jjc795/lilred_management/lilred_management_hardware/LilRedManagementBoard_Rev1.0/BOM/Digikey_BOM/Bill of Materials-lilred_management_board.xls

Designator | Supplier Part Number 1 | Supplier Order Qty 1 | Description | Price (1)
P2, P11 | WM7485-ND | 2 | 4 Pin Microfit Connector | 2.2
J2 | WM5899-ND | 1 | 3 Pin Screw Terminal Block | 6.35
P3 | WM4087-ND | 1 | 8 Pin Microfit connector | 3.07
P6, P9 | WM1876-ND | 2 | 3 Pin Microfit Connector | 1.39
P4, P5, P7, P8, P10, P12 | WM1870-ND | 6 | 2 Pin Microfit Connector | 0.99
P1 | S9009E-03-ND | 1 | Header, 3-Pin, Dual row | 1.13
Q3 | RSC002P03T316CT-ND | 1 | P-Channel MOSFET | 0.27
Q2, Q4, Q5, Q6, Q7, Q8, Q9 | NTR4003NT1GOSCT-ND | 7 | N-Channel MOSFET | 0.27
U1 | ATMEGA328P-AU-ND | 1 | 8-bit AVR Microcontroller, 32KB Flash, 1KB EEPROM, 2KB SRAM, 32-pin TQFP, Industrial Grade (-40°C to 85°C) | 3.58
U6 | 296-38856-1-ND | 1 | 12-Bit 50 kSPS ADC I2C Low Power 8-Channel Multiplexer Internal 2.5 V Reference, -40 to 85 degC, 16-pin SOP (PW16), Green (RoHS & no Sb/Br) | 7.39
J1 | 609-4618-1-ND | 1 | USB-Micro Type B | 0.46
Q1 | 490-1198-1-ND | 1 | Resonator | 0.48
U3, U4, U5 | 296-29034-1-ND | 3 | High or Low Side, Bidirectional Current/Power Monitor with I2C Interface | 3.44
D1 | 160-1448-1-ND | 1 | Yellow LED | 0.31
D2 | 160-1647-1-ND | 1 | Blue LED | 0.52
D3 | 160-1888-1-ND | 1 | Green LED | 0.6
D4 | 160-1447-1-ND | 1 | Red LED | 0.29
U2 | 768-1156-5-ND | 1 | FTDI Serial to USB | 2.12
L1 | 240-2389-1-ND | 1 | Ferrite Bead, 0805 | 0.1
S1 | CKN9104CT-ND | 1 | SPST Button | 0.41
C1, C21, C23 | 478-8115-1-ND | 3 | 10uF, 6.3V, 0805 tantalum pol. | 0.37
C4 | 478-8120-1-ND | 1 | 4.7uF, 6.3V, 0805 tantalum pol. | 0.32
C2, C3, C5, C7, C10, C11, C12, C16, C17, C28, C30 C32 | 490-13406-1-ND | 12 | 0.1uF, 50V, 0603 ceramic | 0.11
C6, C22, C24 | 490-1512-1-ND | 3 | 10nF, 50V, 0603 ceramic | 0.1
C8, C9 | 1276-1037-1-ND | 2 | 47pF, 50V, 0603 ceramic | 0.1
C13, C14, C15, C18, C27, C29 C31 | 490-10732-1-ND | 7 | 1uF, 50V, 0603 ceramic | 0.17
C19, C20, C25, C26 | 490-1368-1-ND | 4 | 510pF, 5V, 0603 ceramic (filter) | 0.18
R1, R5, R12, R13, R43, R44 | 311-470GRCT-ND | 6 | 470, 0603 | 0.1
R2, R9, R10 | 311-10KGRCT-ND | 3 | 10k, 0603 | 0.1
R3, R4, R14, R15, R26 | 311-2.0KGRCT-ND | 5 | 2k, 0603 | 0.1
R6, R7 | 311-1.0KGRCT-ND | 2 | 1k, 0603 | 0.1
R8, R11 | 311-27GRCT-ND | 2 | 27, 0603 | 0.1
R16, R17, R20, R21, R27, R29 | 311-1.00HRCT-ND | 6 | 1, 0603, filter | 0.1
R32, R34, R35, R36, R39, R40 | 311-100KGRCT-ND | 6 | 100k, 0603 | 0.1
R22, R23, R24, R25, R30, R31, R33, R37, R38, R41, R42, R49, R50 | 311-200GRCT-ND | 13 | 200, 0603 | 0.1
R45, R46, R51, R52 | 311-30KDCT-ND | 4 | 30k, 0603, therm pullup | 0.22
R47, R48, R53, R54 | 311-3.0MGRCT-ND | 4 | 3M, 0603, filter | 0.1
R18 | RHM1683-CT-ND | 1 | 1m, 5931, 24V sense | 1.96
R19, R28 | RHM.001APCT-ND | 2 | 1m, 1210, sense | 0.64
