jjc795/lilred_management/lilred_management_hardware/LilRedManagementBoard_Rev1.0/lilred_management_board.PDF

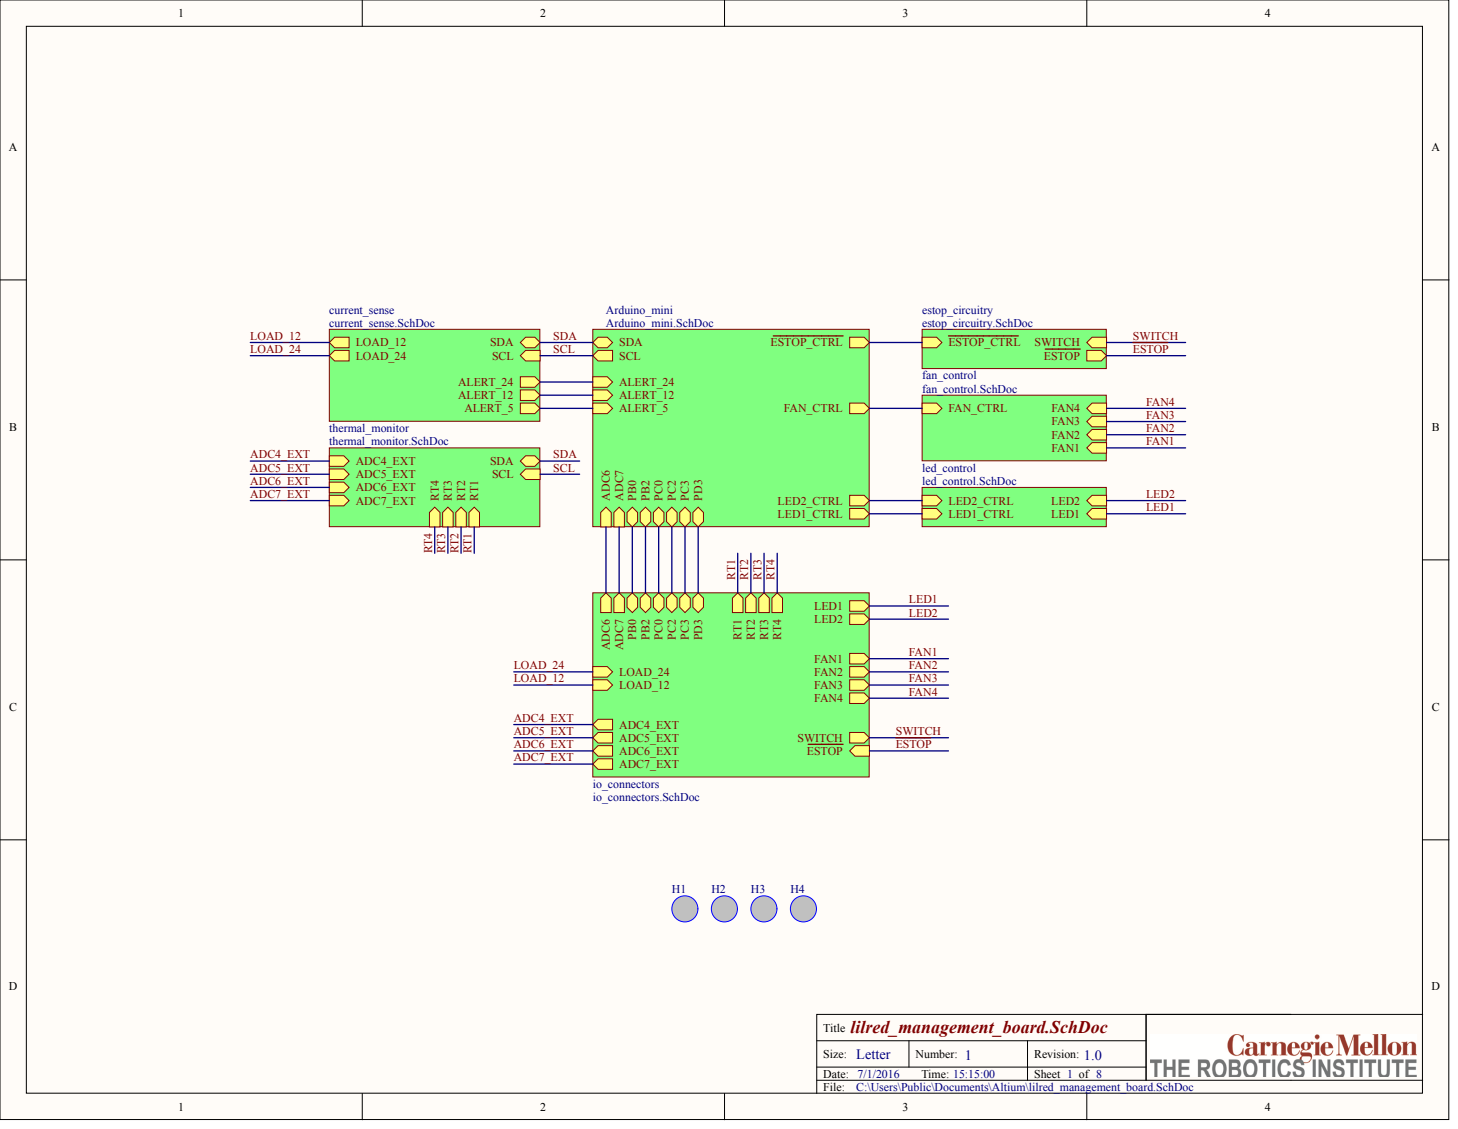
[picture p1: page 1]

Title lilred_management_board.SchDoc

Size: Letter | Number: 1 | Revision: 1.0
Date: 7/1/2016 Time: 15:15:00 | | Sheet 1 of 8
File: C:\Users\Public\Documents\Altium\lilred_management_board.SchDoc

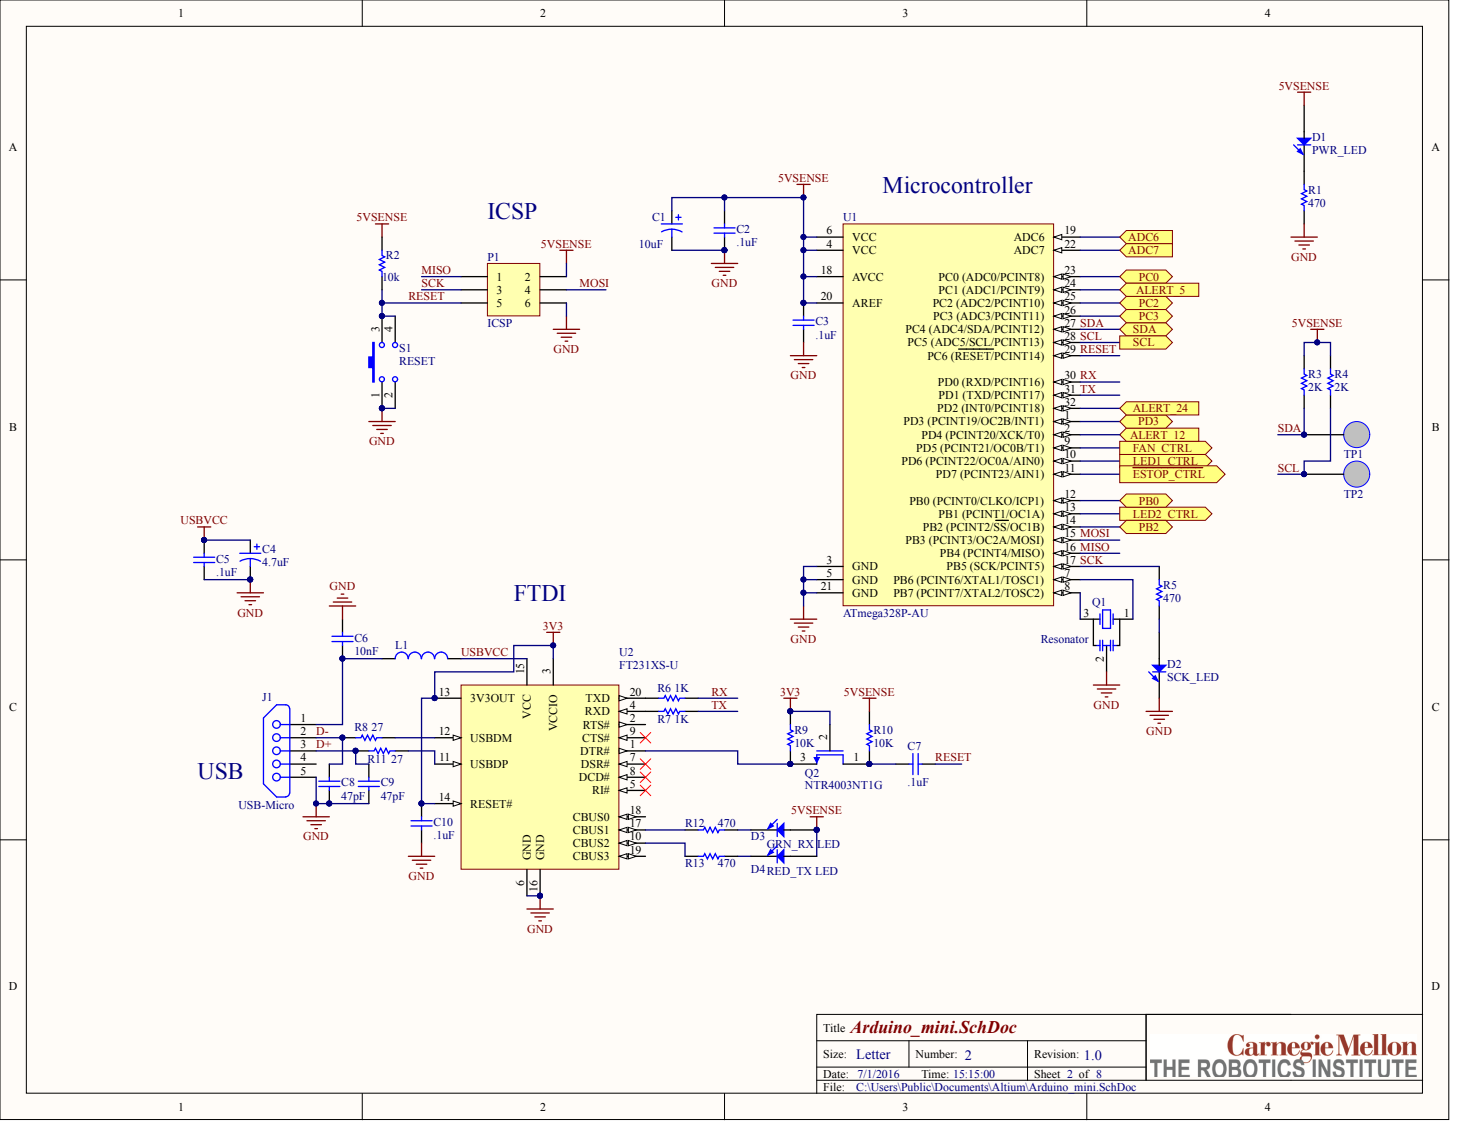
[picture p2: page 2]

5VSENSE | D1

Title Arduino_mini.SchDoc

Size: Letter | Number: 2 | Revision: 1.0
Date: 7/1/2016 Time: 15:15:00 | | Sheet 2 of 8
File: C:\Users\Public\Documents\Altium\Arduino_mini.SchDoc

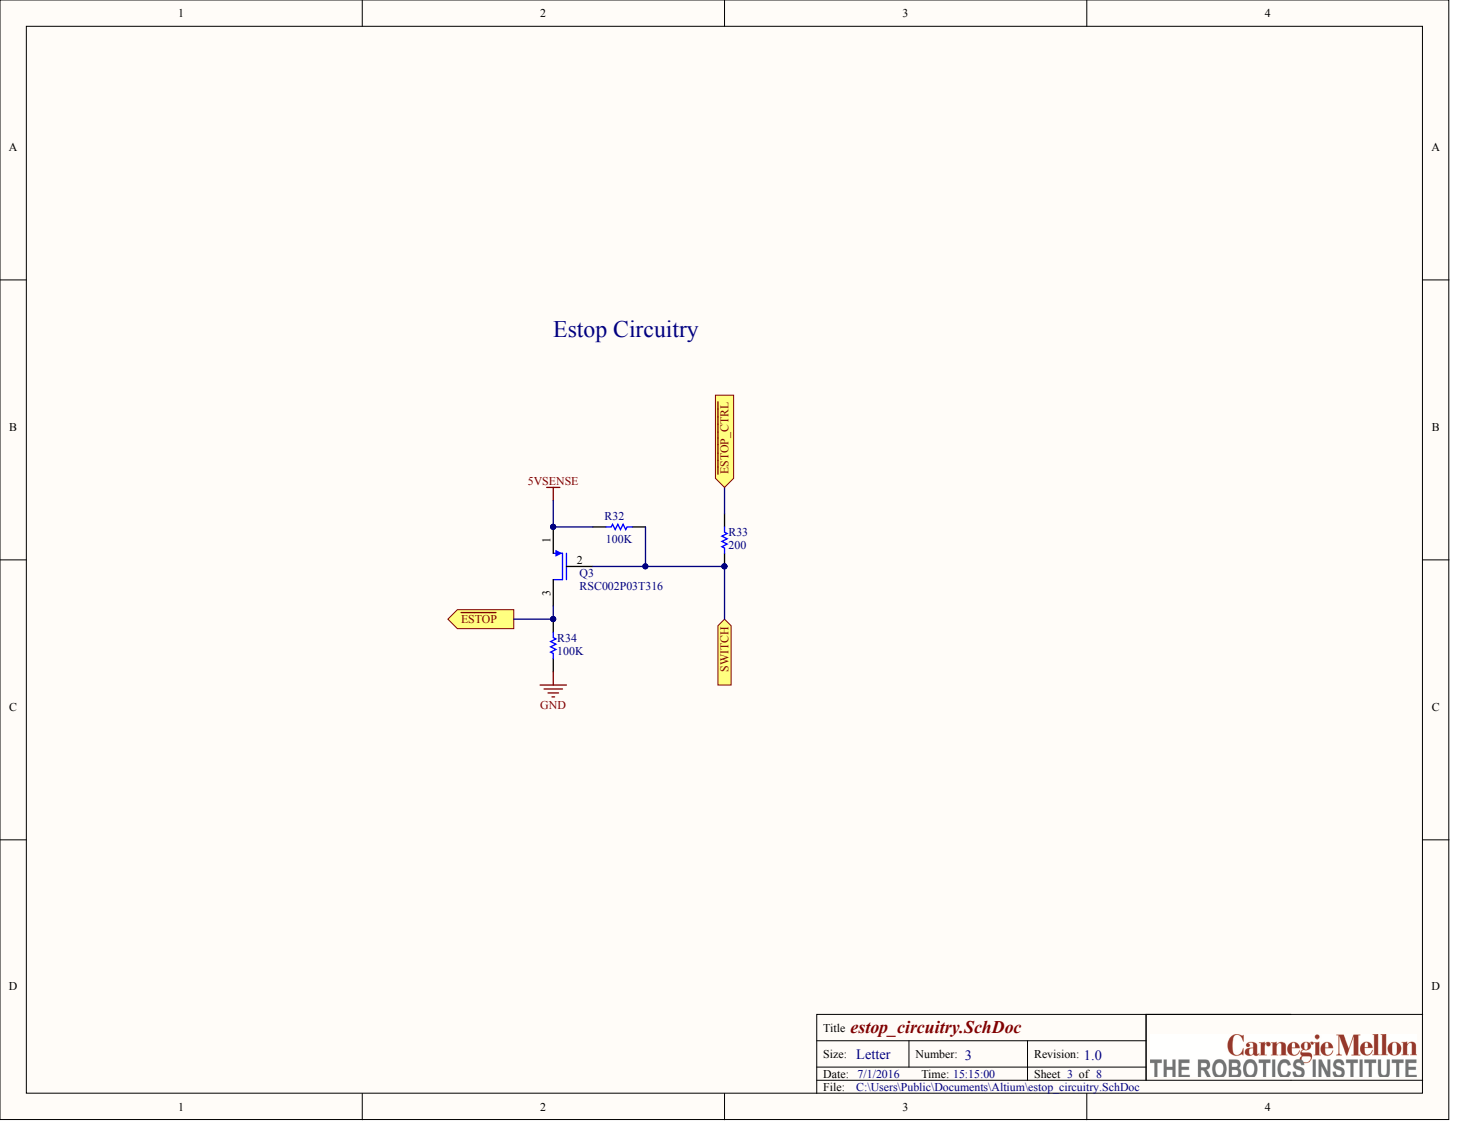
[picture p3: page 3]

Title estop_circuitry.SchDoc

Size: Letter | Number: 3 | Revision: 1.0
Date: 7/1/2016 Time: 15:15:00 | | Sheet 3 of 8
File: C:\Users\Public\Documents\Altium\estop_circuitry.SchDoc

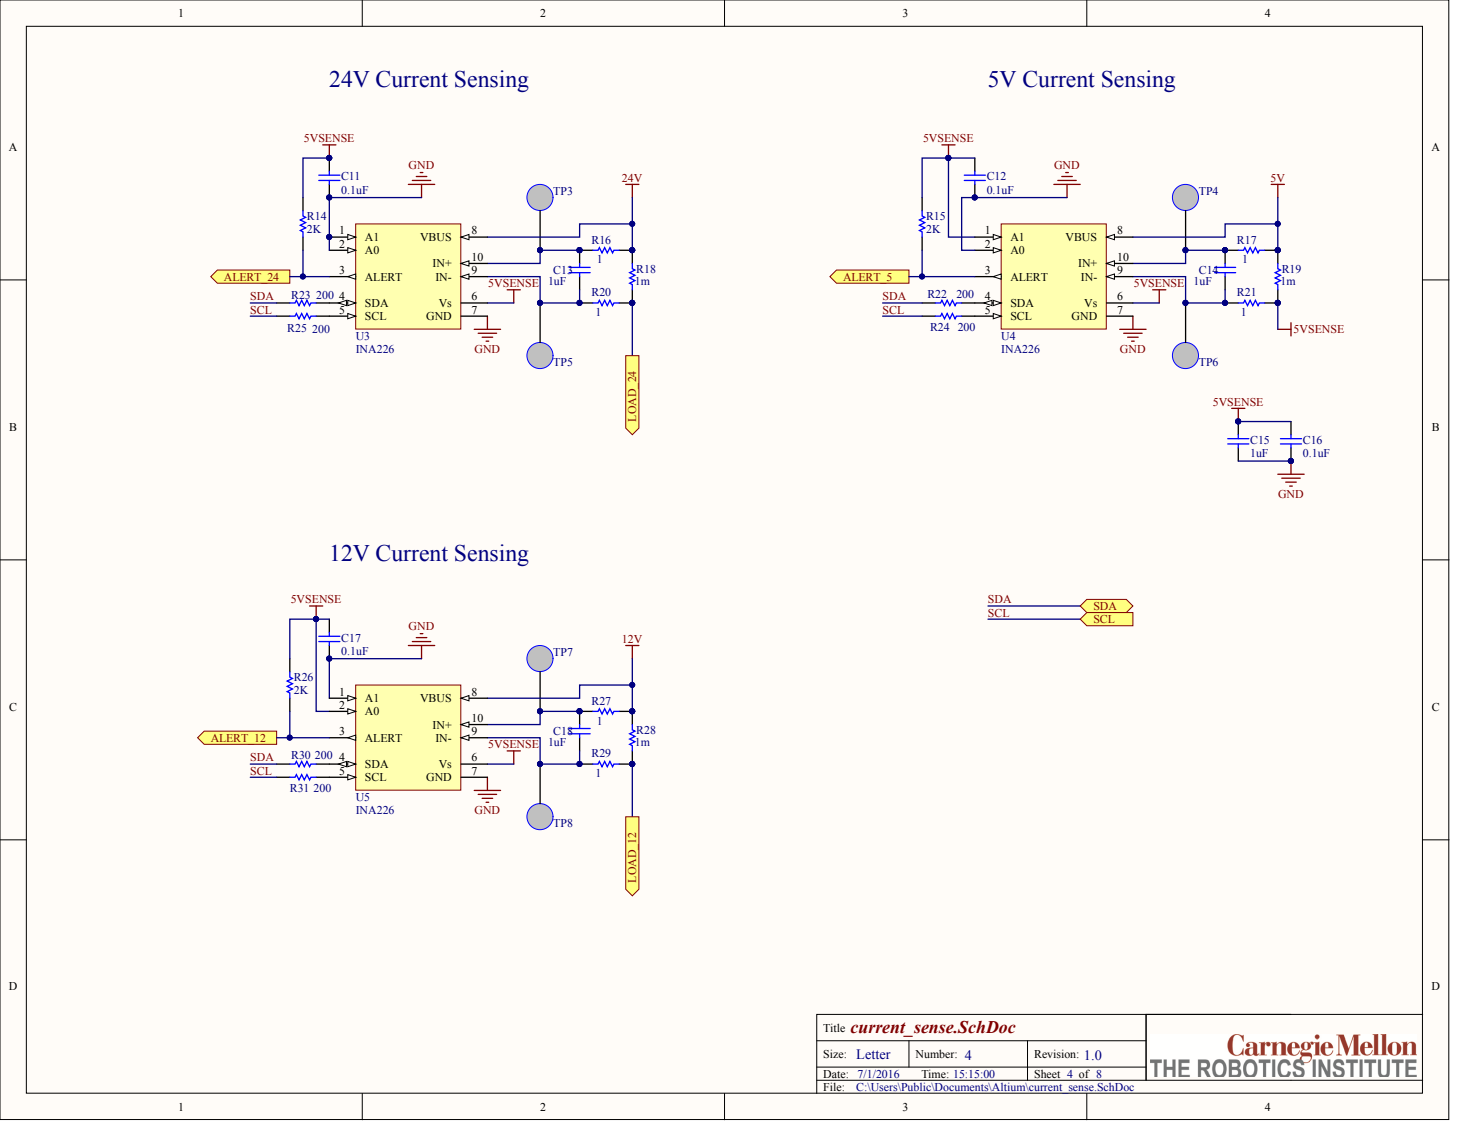
[picture p4: page 4]

Title current_sense.SchDoc

Size: Letter | Number: 4 | Revision: 1.0
Date: 7/1/2016 Time: 15:15:00 | | Sheet 4 of 8
File: C:\Users\Public\Documents\Altium\current_sense.SchDoc

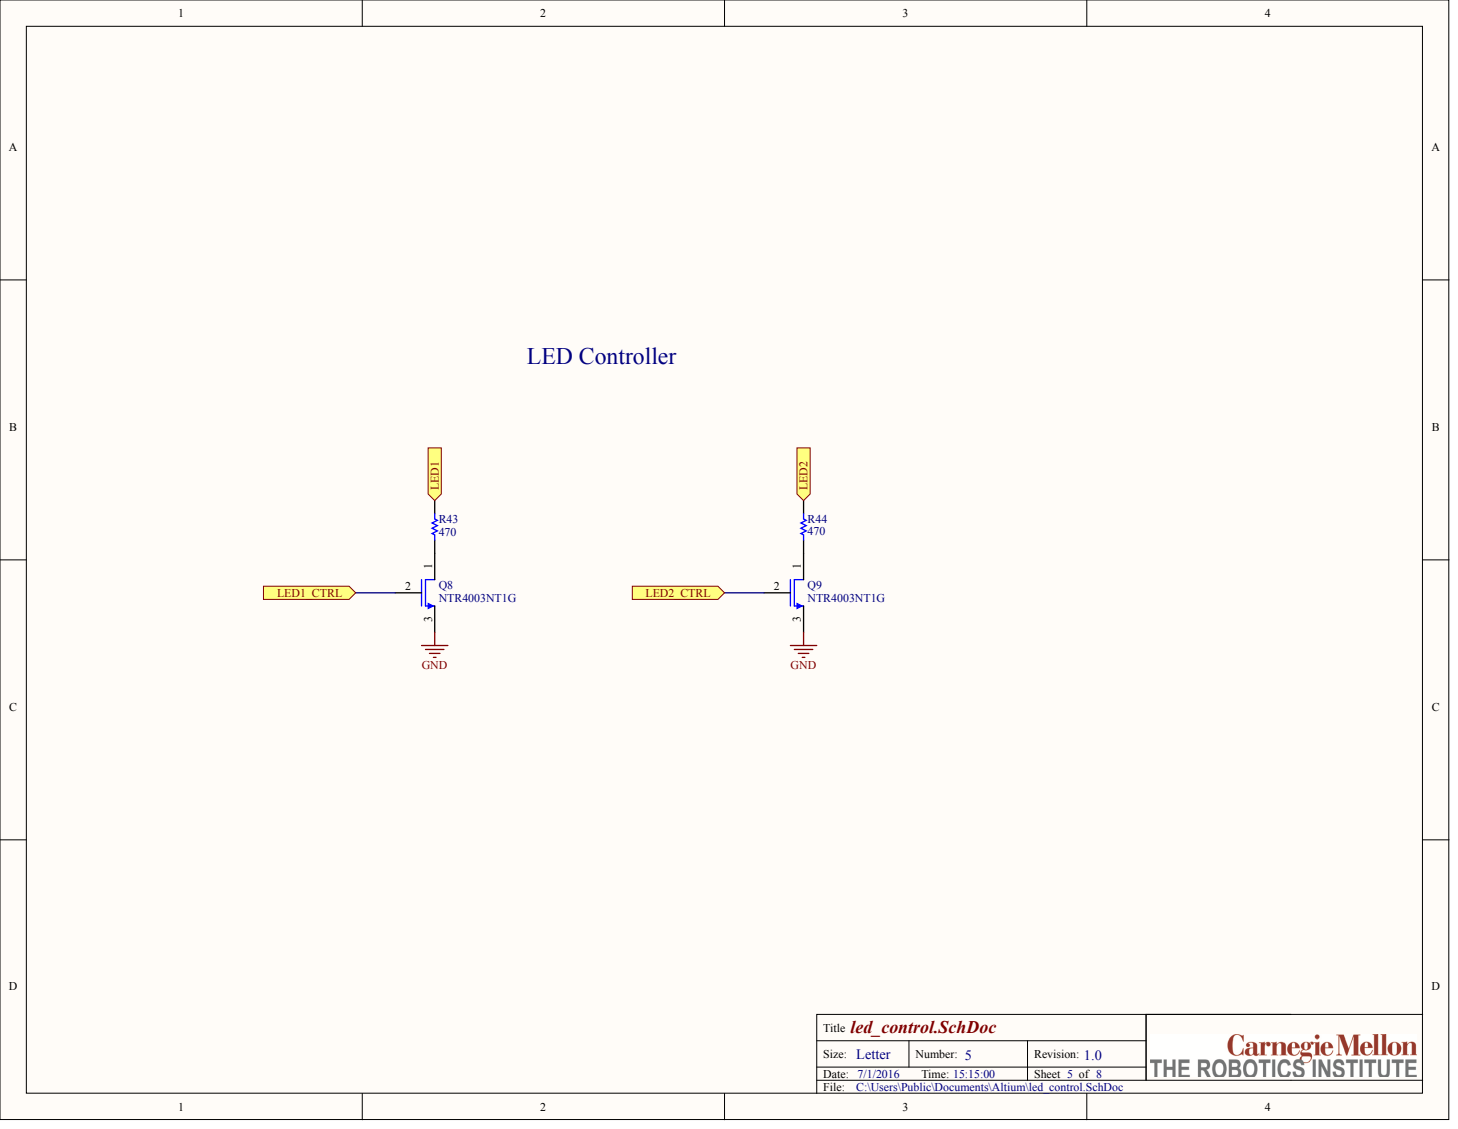
[picture p5: page 5]

Title led_control.SchDoc

Size: Letter | Number: 5 | Revision: 1.0
Date: 7/1/2016 Time: 15:15:00 | | Sheet 5 of 8
File: C:\Users\Public\Documents\Altium\led_control.SchDoc

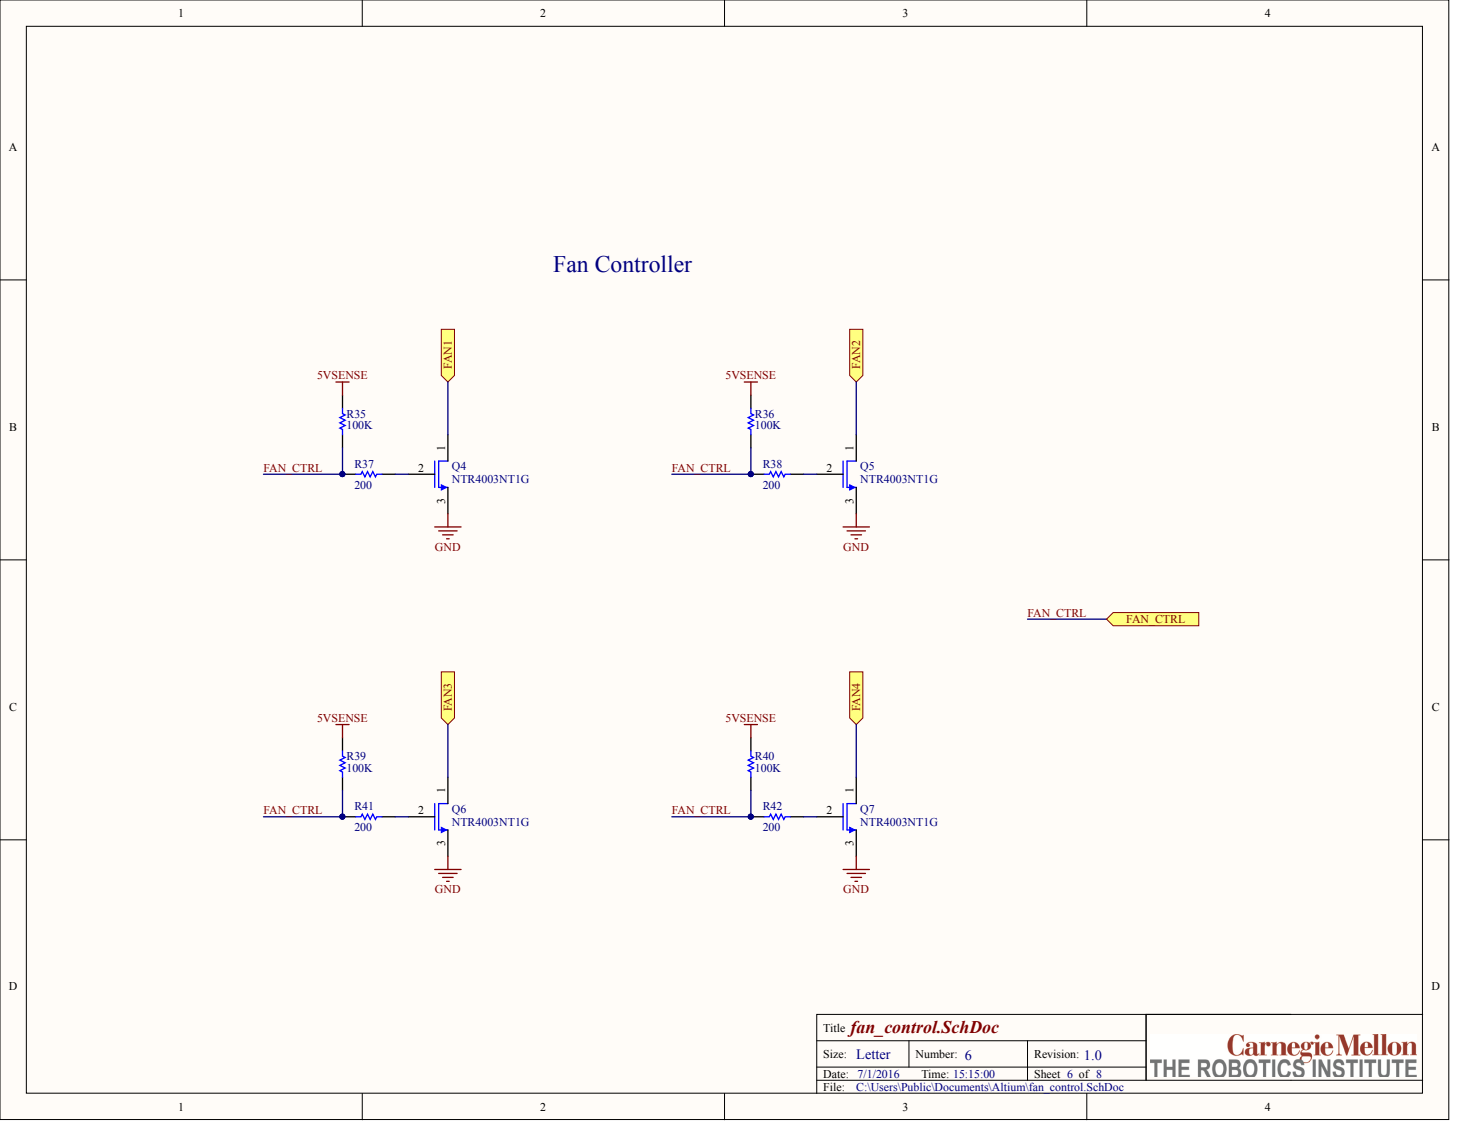
[picture p6: page 6]

Title fan_control.SchDoc

Size: Letter | Number: 6 | Revision: 1.0
Date: 7/1/2016 Time: 15:15:00 | | Sheet 6 of 8
File: C:\Users\Public\Documents\Altium\fan_control.SchDoc

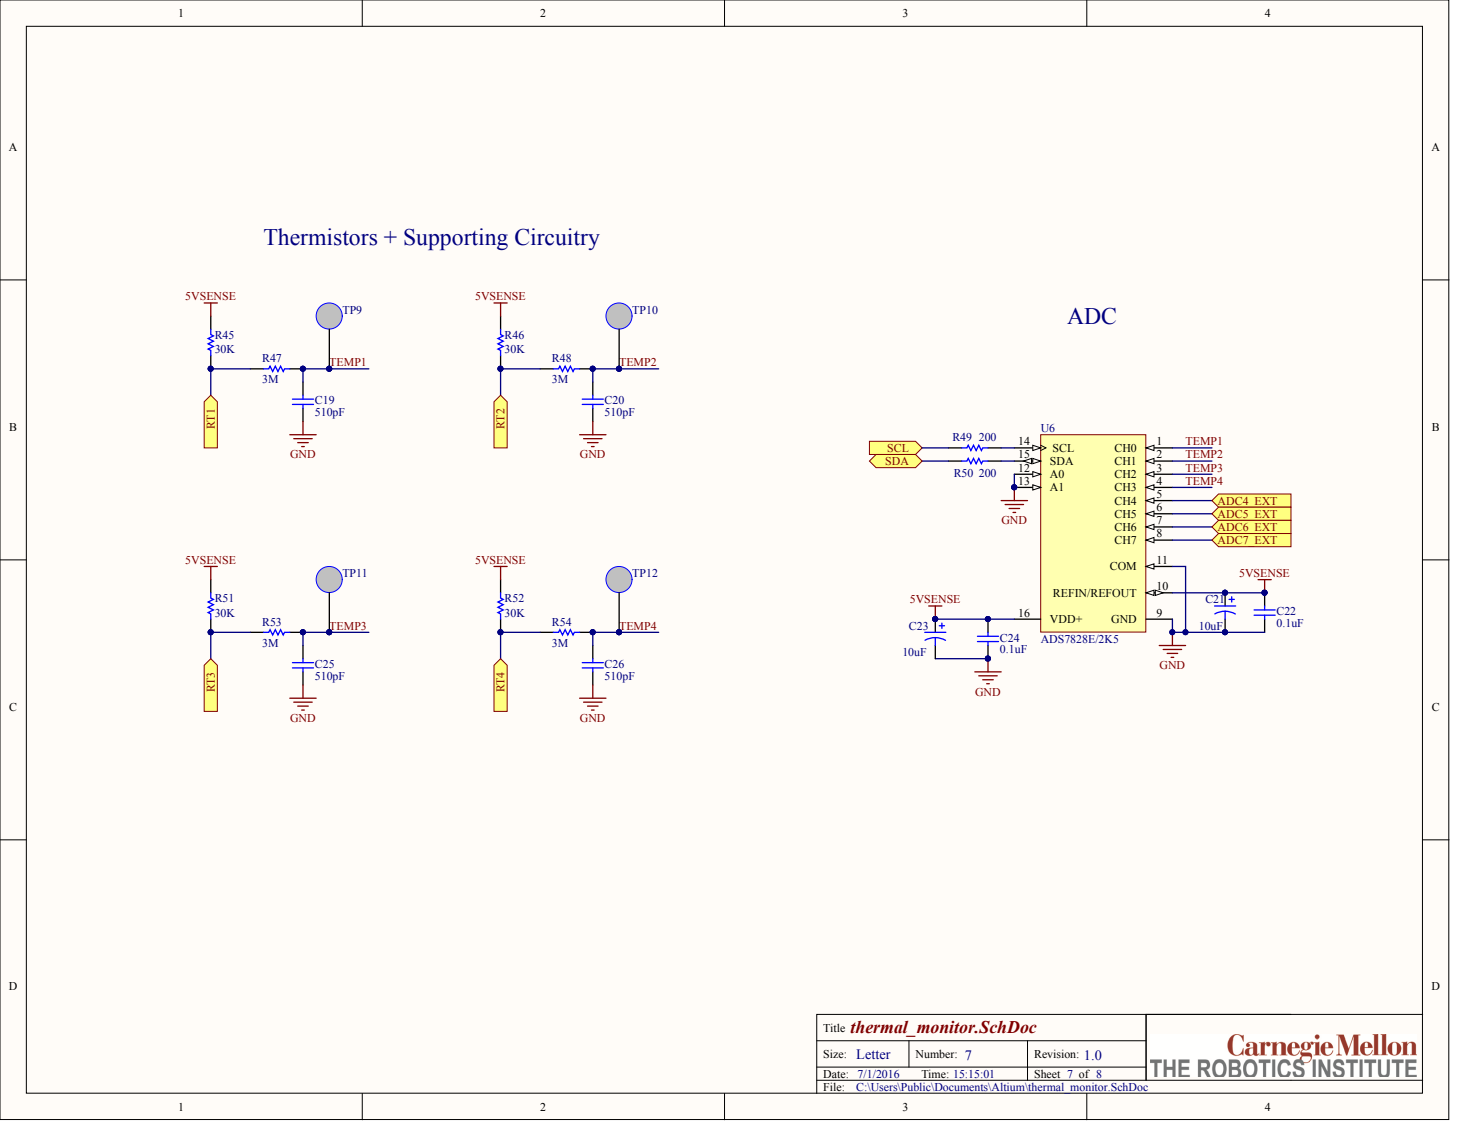
[picture p7: page 7]

Title thermal_monitor.SchDoc

Size: Letter | Number: 7 | Revision: 1.0
Date: 7/1/2016 Time: 15:15:01 | | Sheet 7 of 8
File: C:\Users\Public\Documents\Altium\thermal_monitor.SchDoc

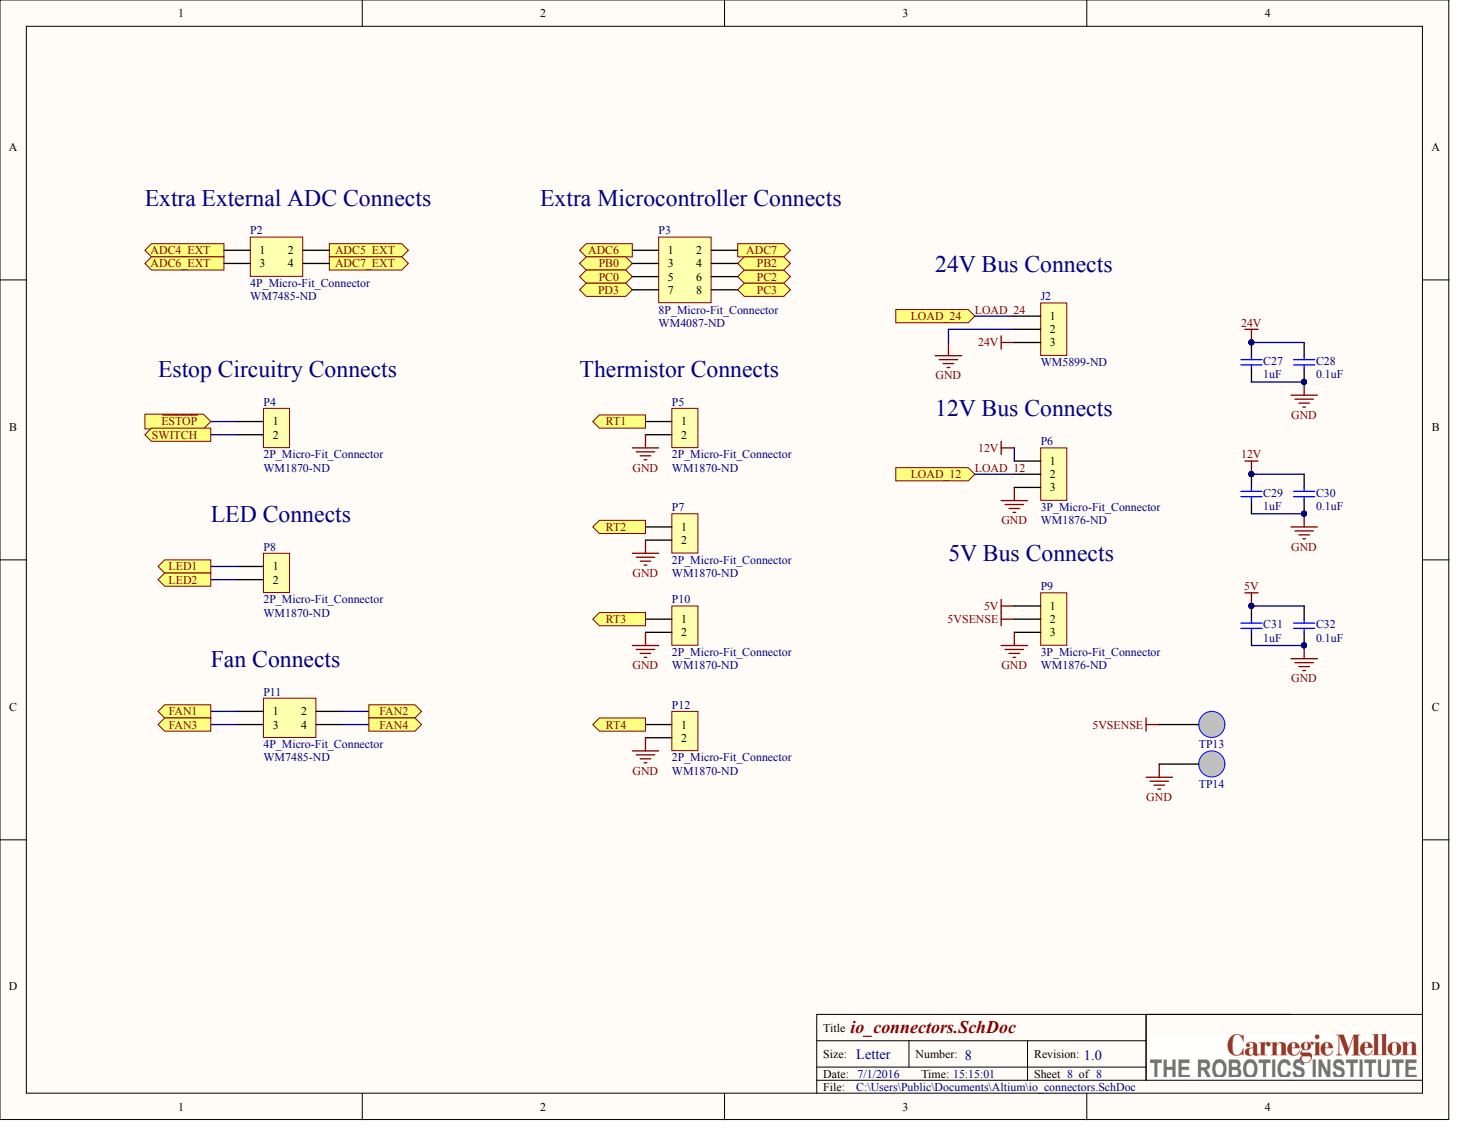
[picture p8: page 8]

Title io_connectors.SchDoc

Size: Letter | Number: 8 | Revision: 1.0
Date: 7/1/2016 Time: 15:15:01 | | Sheet 8 of 8
File: C:\Users\Public\Documents\Altium\io_connectors.SchDoc
