jjc795/lilred_management/(list of files, drawings)

Other design files:
lilred_management_hardware/LilRedManagementBoard_Rev1.0/Arduino_mini.SchDoc
lilred_management_hardware/LilRedManagementBoard_Rev1.0/current_sense.SchDoc
lilred_management_hardware/LilRedManagementBoard_Rev1.0/estop_circuitry.SchDoc
lilred_management_hardware/LilRedManagementBoard_Rev1.0/fan_control.SchDoc
lilred_management_hardware/LilRedManagementBoard_Rev1.0/io_connectors.SchDoc
lilred_management_hardware/LilRedManagementBoard_Rev1.0/led_control.SchDoc
lilred_management_hardware/LilRedManagementBoard_Rev1.0/lilred_management_board.PcbDoc
lilred_management_hardware/LilRedManagementBoard_Rev1.0/lilred_management_board.PrjPcb
lilred_management_hardware/LilRedManagementBoard_Rev1.0/lilred_management_board.SchDoc
lilred_management_hardware/LilRedManagementBoard_Rev1.0/thermal_monitor.SchDoc
