jjc795/lilred_management/(commit log)

2016-07-21 added computer software to interface with board and rviz
2016-07-27 fan control button
2016-07-28 working on voltage to temp conversion
2016-07-28 updated voltage to temp
2016-08-04 working on dyn recfg modes option
    [lilred.cfg]
2016-08-05 added modes and better pose updates
    [lilred.cfg]
2016-08-05 updated config file
    [lilred.cfg]
2016-08-05 updated cfg
    [lilred.cfg]
2016-08-06 added board files
    [Arduino_mini.SchDoc, Bill of Materials-lilred_management_board.xls, current_sense.SchDoc, estop_circuitry.SchDoc, fan_control.SchDoc, io_connectors.SchDoc, led_control.SchDoc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]
